risingtideresearch/CANbus-Logging-Bridge/README.md

# CANbus-Logging-Bridge
Platform for collecting, logging, interpreting, and relaying CAN messages on multiple busses
