risingtideresearch/CANbus-Logging-Bridge/(threads)

Thread 1 (2025-07-22):

Changes from V01 testing

NPoole, 2025-07-22:
I'm going to use this issue to track my TODO as I test the prototype.

First on the list, I'll probably rename this repo and the project "CANbus Gateway" because that's what the name has become in meetings and it's less of a mouthful.

NPoole, 2025-07-22:
- Not proven to cause problems yet, but a mistake none-the-less: the VUSB LDO's enable pin is connected directly to VUSB while the input pin gets VUSB through a diode drop. The enable pin should get the same level as the input.
