risingtideresearch/CANbus-Logging-Bridge/CANbus_Logging_Bridge/CANbus_Logging_Bridge.kicad_pcb

## KiCad design CANbus_Logging_Bridge/CANbus_Logging_Bridge.kicad_pcb (2025-05-25)

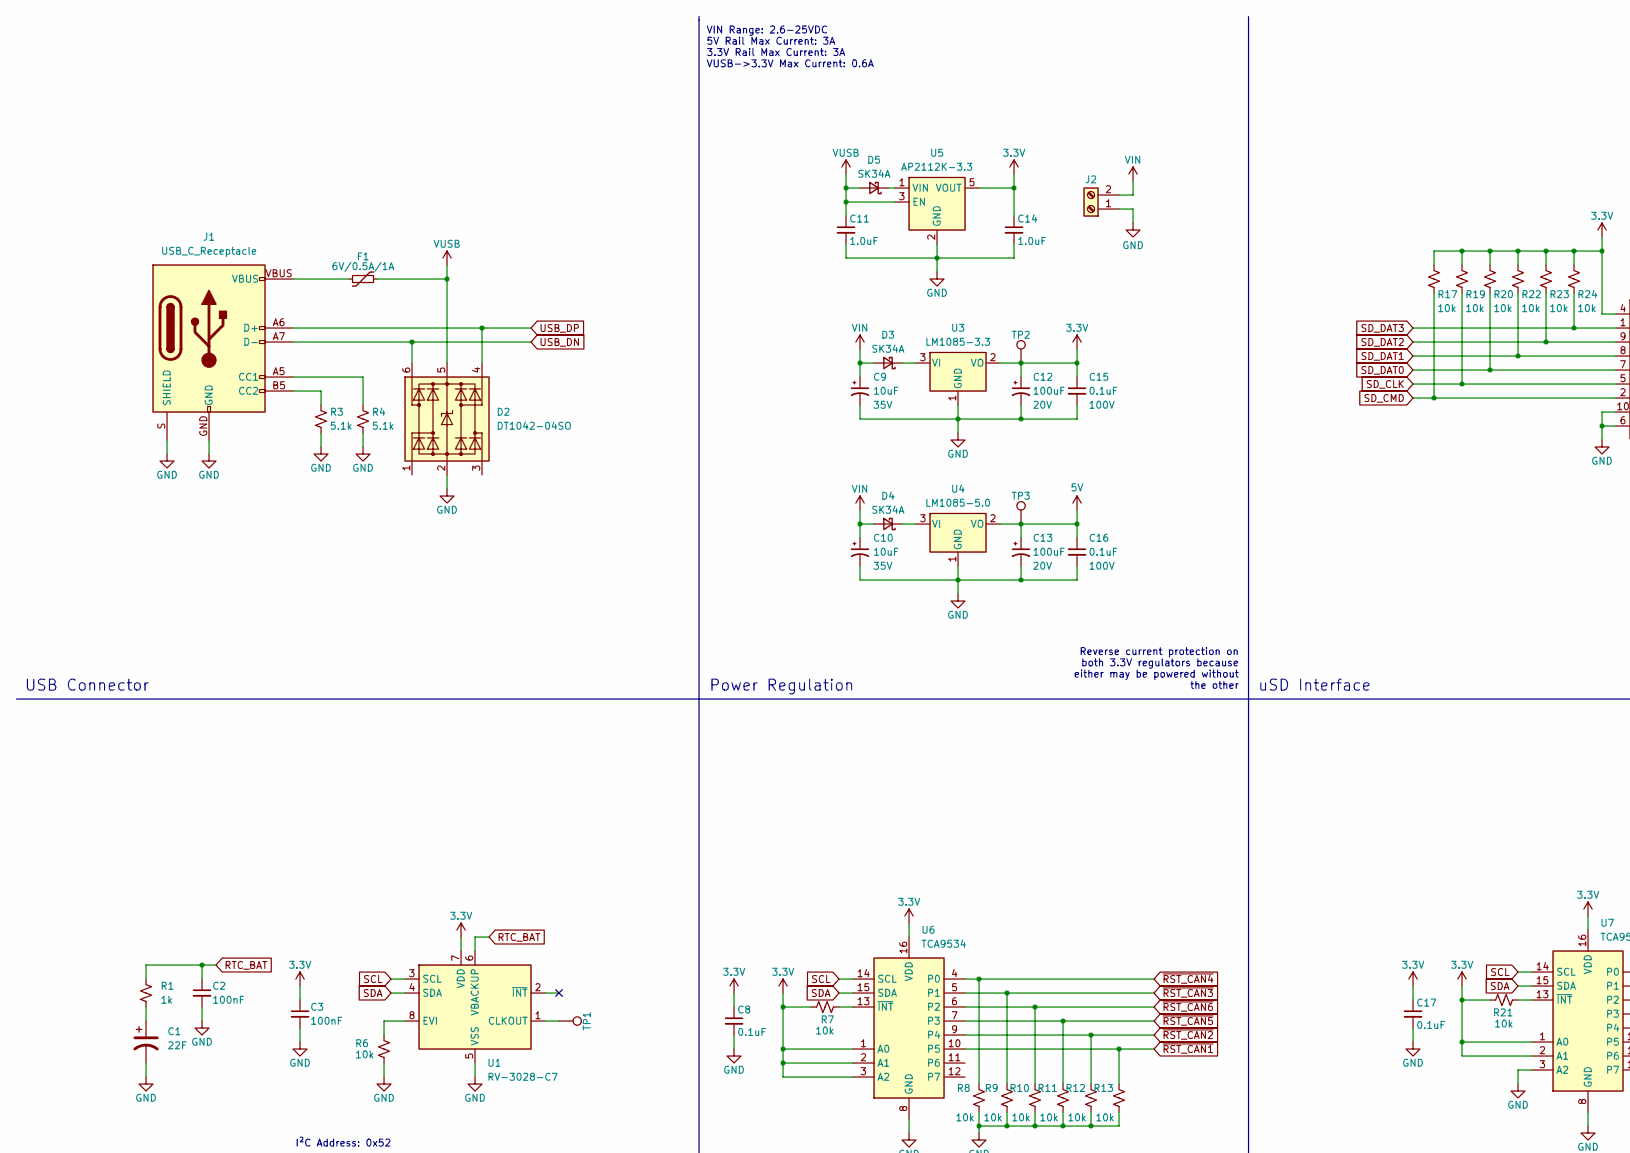
[picture p1: schematic CANbus_Logging_Bridge.kicad_sch, CAN Bus Logging and Bridge, part in row 1, column 1]

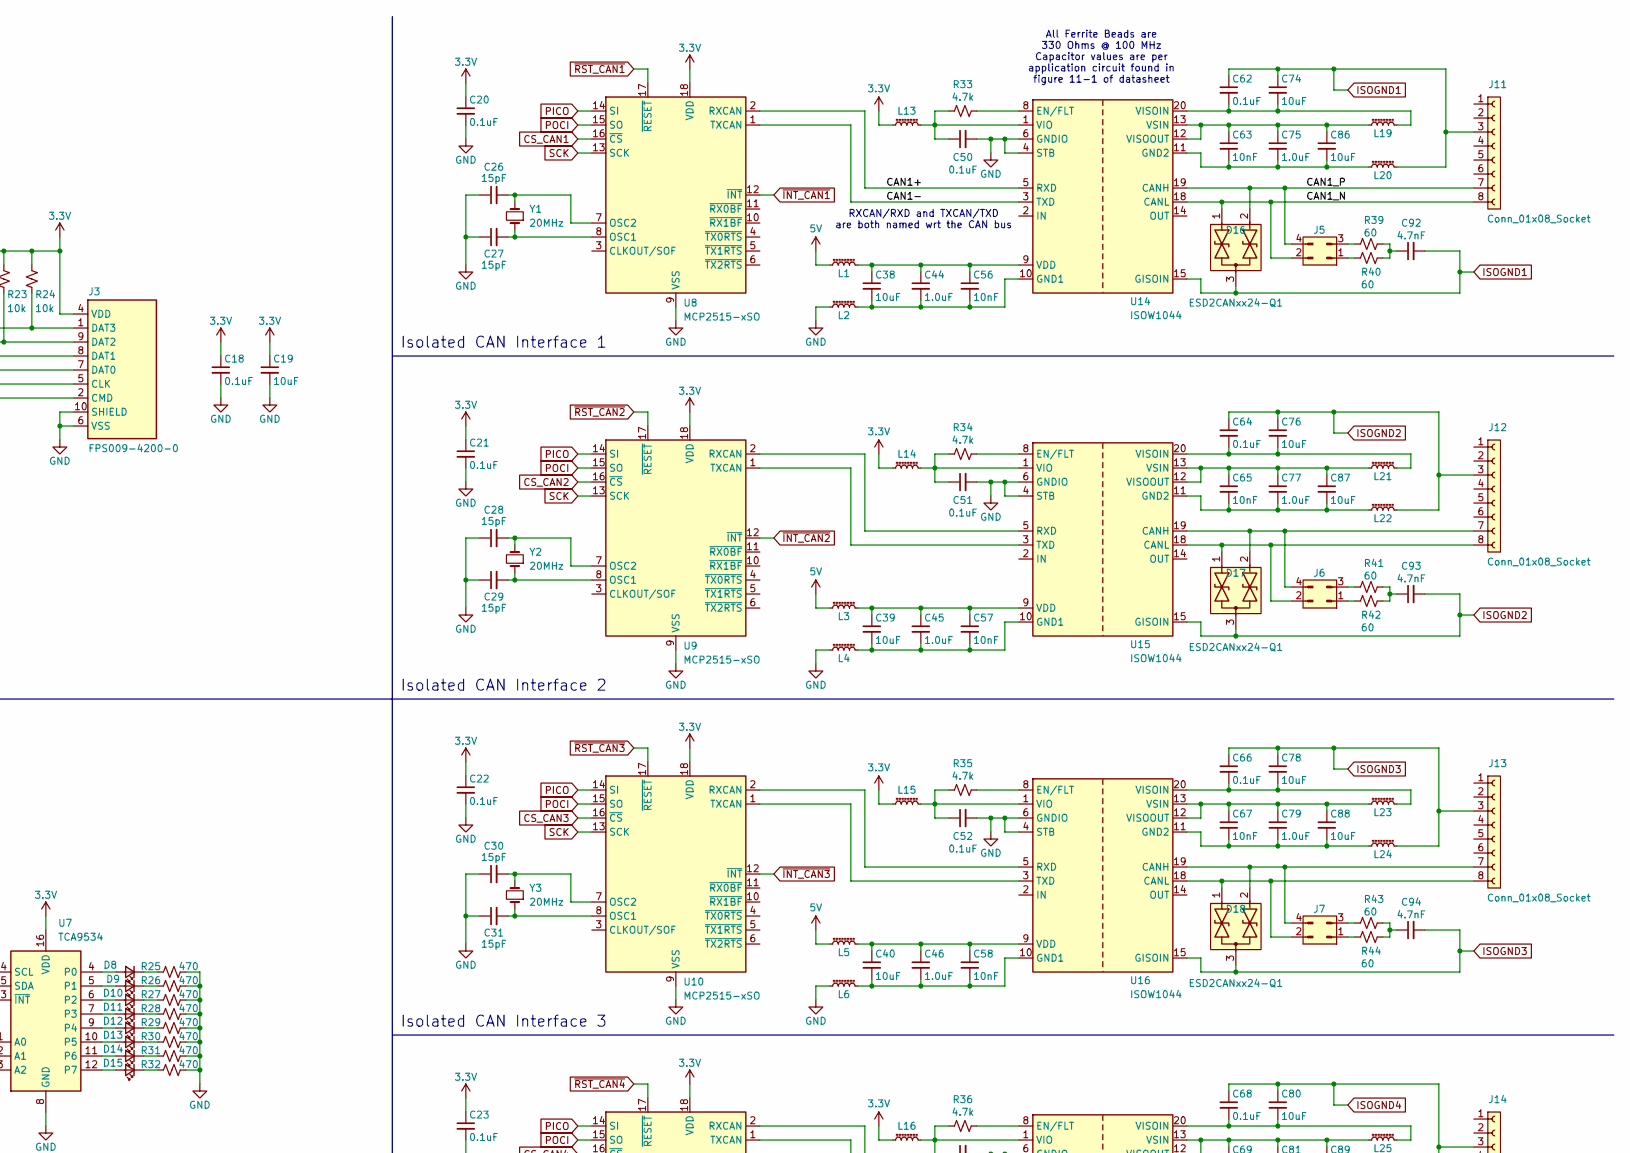
[picture p2: schematic CANbus_Logging_Bridge.kicad_sch, CAN Bus Logging and Bridge, part in row 1, column 2]

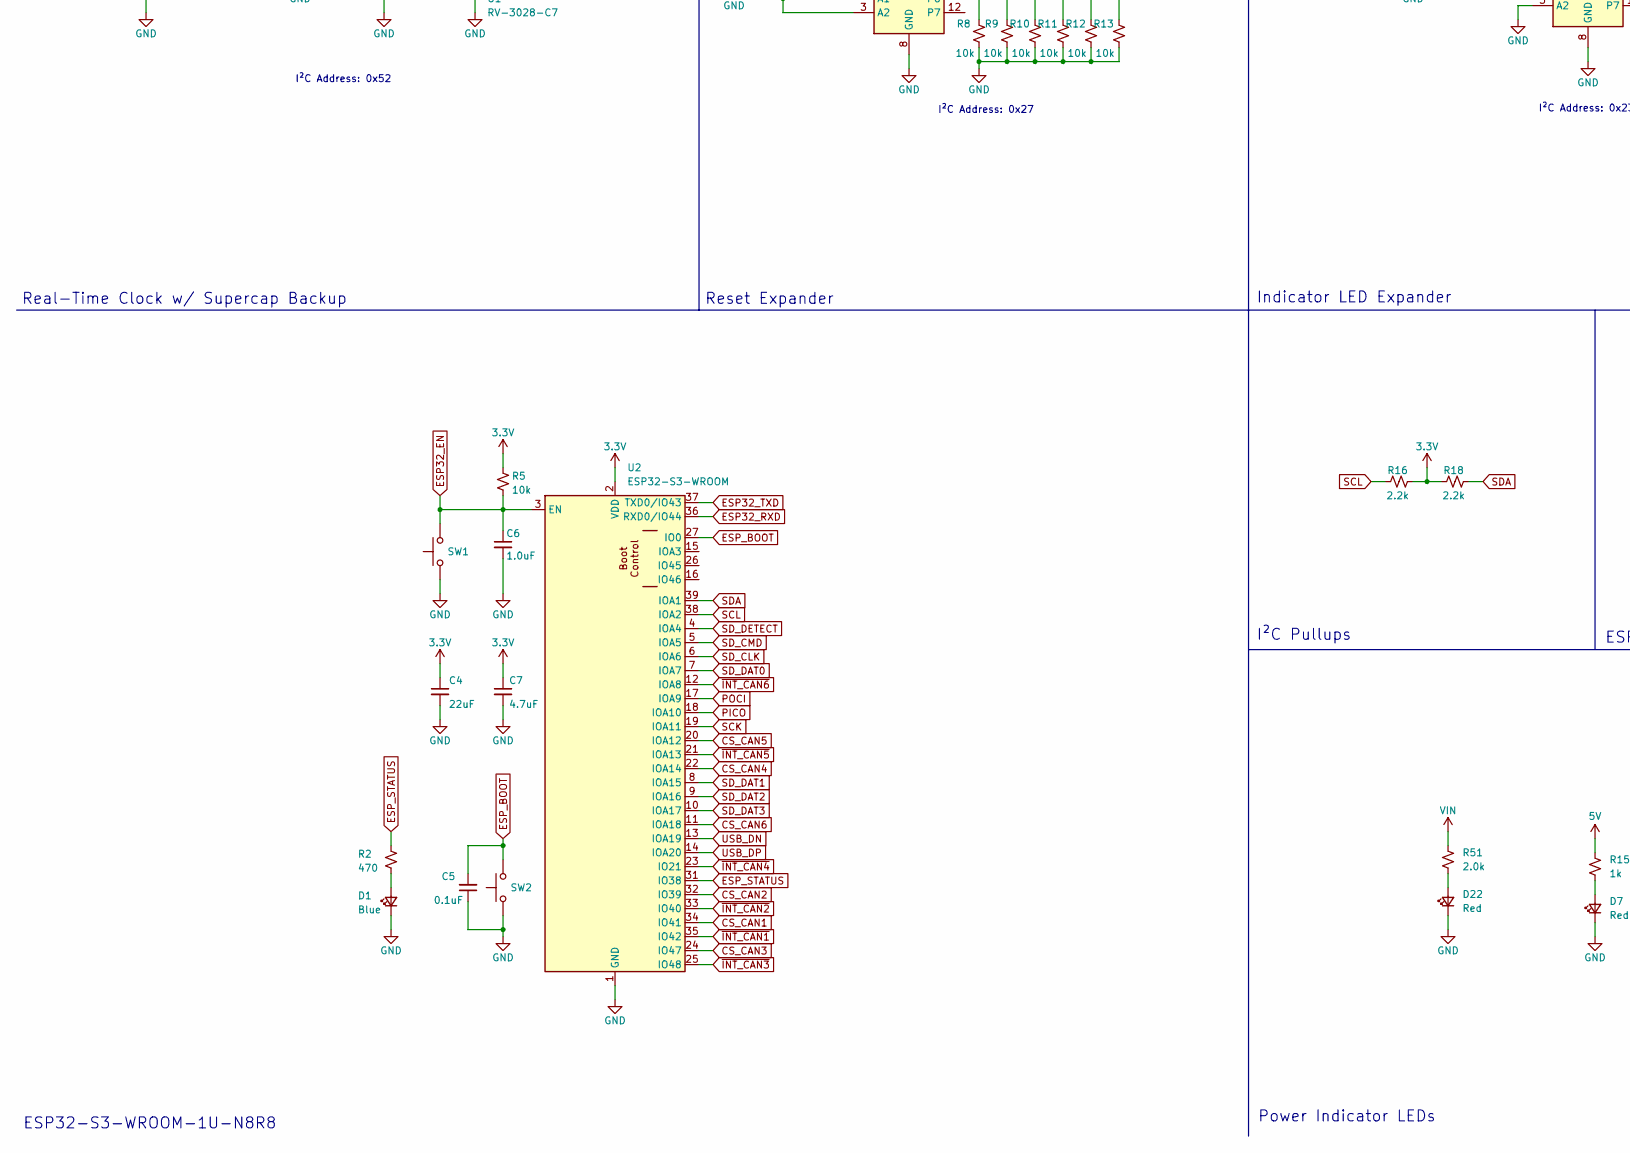
[picture p3: schematic CANbus_Logging_Bridge.kicad_sch, CAN Bus Logging and Bridge, part in row 2, column 1]

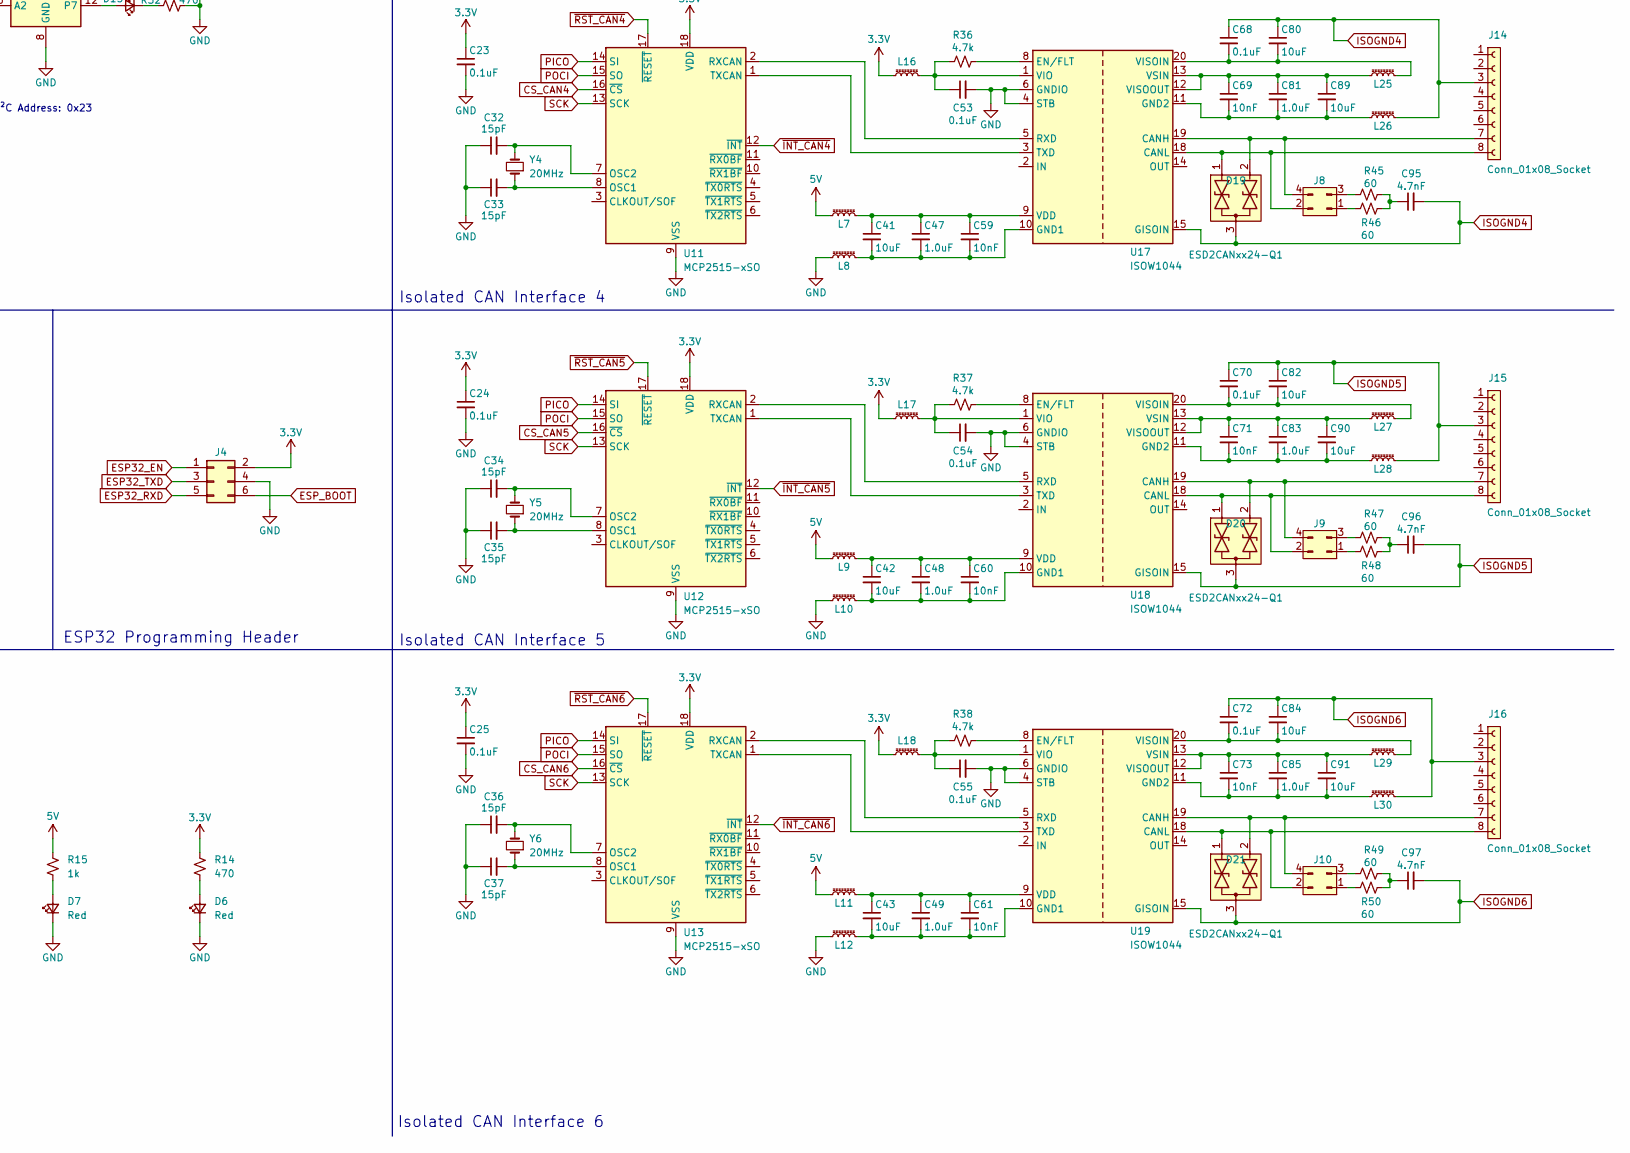
[picture p4: schematic CANbus_Logging_Bridge.kicad_sch, CAN Bus Logging and Bridge, part in row 2, column 2]

Parts:
C1: 22F; 4.8_CoinCell_Dynacap
C2, C3: 100nF; C_0402_1005Metric; Voltage 25V; Tolerance 10%
C4: 22uF; C_0402_1005Metric; Voltage 6.3V; Tolerance 20%
C5, C8, C17, C18, C20, C21, C22, C23, C24, C25, C50, C51, C52, C53, C54, C55, C62, C64, C66, C68, C70, C72: 0.1uF; C_0402_1005Metric; Voltage 16V; Tolerance 10%
C6, C11, C14, C44, C45, C46, C47, C48, C49, C75, C77, C79, C81, C83, C85: 1.0uF; C_0402_1005Metric; Voltage 16V; Tolerance 10%
C7: 4.7uF; C_0402_1005Metric; Voltage 6.3V; Tolerance 20%
C9, C10: 10uF; CP_EIA-7343-30_AVX-N; Voltage 35V; Tolerance 20%
C12, C13: 100uF; CP_EIA-7343-30_AVX-N; Voltage 20V; Tolerance 10%
C15, C16: 0.1uF; C_0603_1608Metric; Voltage 100V; Tolerance 10%
C19, C38, C39, C40, C41, C42, C43, C74, C76, C78, C80, C82, C84, C86, C87, C88, C89, C90, C91: 10uF; C_0402_1005Metric; Voltage 6.3V; Tolerance 20%
C26, C27, C28, C29, C30, C31, C32, C33, C34, C35, C36, C37: 15pF; C_0402_1005Metric; Voltage 50V; Tolerance 5%
C56, C57, C58, C59, C60, C61, C63, C65, C67, C69, C71, C73: 10nF; C_0402_1005Metric; Voltage 25V; Tolerance 10%
C92, C93, C94, C95, C96, C97: 4.7nF; C_0402_1005Metric
D1, D8, D9, D10, D11, D12, D13, D14, D15: Blue; LED_0603_1608Metric
D2: DT1042-04SO; SOT23-6
D3, D4, D5: SK34A; SMA
D6, D7, D22: Red; LED_0603_1608Metric
D16, D17, D18, D19, D20, D21: ESD2CANxx24-Q1; SOT-323_SC-70
F1: 6V/0.5A/1A; 0805
J1: USB_C_Receptacle; USB-C_16
J2: Screw_Terminal_01x02; TerminalBlock_DoraboDBT10_8.5mm
J3: FPS009-4200-0; FPS00942000; Mouser Part Number 945-FPS009-4200-0
J4: Conn_02x03_Odd_Even; PinHeader_2x03_P2.54mm_Vertical
J5, J6, J7, J8, J9, J10: Conn_02x02_Pin; PinHeader_2x02_P2.54mm_Vertical_SMD
J11, J12, J13, J14, J15, J16: Conn_01x08_Socket; 1x08
L1, L2, L3, L4, L5, L6, L7, L8, L9, L10, L11, L12, L13, L14, L15, L16, L17, L18, L19, L20, L21, L22, L23, L24, L25, L26, L27, L28, L29, L30: 330 OHM; C_0402_1005Metric
R1, R15: 1k; R_0402_1005Metric
R2, R14, R25, R26, R27, R28, R29, R30, R31, R32: 470; R_0402_1005Metric
R3, R4: 5.1k; R_0402_1005Metric
R5, R6, R7, R8, R9, R10, R11, R12, R13, R17, R19, R20, R21, R22, R23, R24: 10k; R_0402_1005Metric
R16, R18: 2.2k; R_0402_1005Metric
R33, R34, R35, R36, R37, R38: 4.7k; R_0402_1005Metric
R39, R40, R41, R42, R43, R44, R45, R46, R47, R48, R49, R50: 60; R_0402_1005Metric
R51: 2.0k; R_1206_3216Metric
SW1, SW2: SMD_5.2x5.2mm_h1.9mm; Push_SMD_5.2x5.2mm_h1.9mm
TP1, TP2, TP3: 1.0mm; TestPoint-1.0mm
U1: RV-3028-C7; MicroCrystal_C7_SON-8_1.5x3.2mm_P0.9mm
U2: ESP32-S3-WROOM; ESP32-S3-WROOM-1U
U3: LM1085-3.3; TO-263-3_TabPin2
U4: LM1085-5.0; TO-263-3_TabPin2
U5: AP2112K-3.3; SOT23-5
U6, U7: TCA9534; SOIC-16W_7.5x10.3mm_P1.27mm
U8, U9, U10, U11, U12, U13: MCP2515-xSO; SOIC-18W_7.5x11.6mm_P1.27mm
U14, U15, U16, U17, U18, U19: ISOW1044; SOIC-20W_7.5x12.8mm_P1.27mm
Y1, Y2, Y3, Y4, Y5, Y6: 20MHz; Crystal_SMD_2.0x1.6mm

Connections:
3.3V: C3.1, C4.1, C7.1, C8.1, C12.1, C14.1, C15.1, C17.1, C18.1, C19.1, C20.1, C21.1, C22.1, C23.1, C24.1, C25.1, J3.4 (VDD), J4.2, L13.1, L14.1, L15.1, L16.1, L17.1, L18.1, R5.2, R7.1, R14.2, R16.1, R17.2, R18.2, R19.2, R20.2, R21.1, R22.2, R23.2, R24.2, TP2.1, U1.7 (VDD), U2.2 (VDD), U3.2 (VO), U5.5 (VOUT), U6.1 (A0), U6.2 (A1), U6.3 (A2), U6.16 (VDD), U7.1 (A0), U7.2 (A1), U7.16 (VDD), U8.18 (VDD), U9.18 (VDD), U10.18 (VDD), U11.18 (VDD), U12.18 (VDD), U13.18 (VDD)
5V: C13.1, C16.1, L1.1, L3.1, L5.1, L7.1, L9.1, L11.1, R15.2, TP3.1, U4.2 (VO)
/CAN1+: U8.2 (RXCAN), U14.5 (RXD)
/CAN1-: U8.1 (TXCAN), U14.3 (TXD)
/CAN1_N: D16.1 (A1), J5.2, J11.8, U14.18 (CANL)
/CAN1_P: D16.2 (A2), J5.4, J11.7, U14.19 (CANH)
CS_CAN1: U2.34 (IO41), U8.16 (~CS)
CS_CAN2: U2.32 (IO39), U9.16 (~CS)
CS_CAN3: U2.24 (IO47), U10.16 (~CS)
CS_CAN4: U2.22 (IOA14), U11.16 (~CS)
CS_CAN5: U2.20 (IOA12), U12.16 (~CS)
CS_CAN6: U2.11 (IOA18), U13.16 (~CS)
ESP32_EN: C6.1, J4.1, R5.1, SW1.2, U2.3 (EN)
ESP32_RXD: J4.5, U2.36 (RXD0/IO44)
ESP32_TXD: J4.3, U2.37 (TXD0/IO43)
ESP_BOOT: C5.2, J4.6, SW2.2, U2.27 (IO0)
ESP_STATUS: R2.2, U2.31 (IO38)
GND: C1.-, C2.2, C3.2, C4.2, C5.1, C6.2, C7.2, C8.2, C9.2, C10.2, C11.2, C12.2, C13.2, C14.2, C15.2, C16.2, C17.2, C18.2, C19.2, C20.2, C21.2, C22.2, C23.2, C24.2, C25.2, C26.1, C27.1, C28.1, C29.1, C30.1, C31.1, C32.1, C33.1, C34.1, C35.1, C36.1, C37.1, C50.2, C51.2, C52.2, C53.2, C54.2, C55.2, D1.1 (K), D2.2 (GND), D6.1 (K), D7.1 (K), D22.1 (K), J1.GND, J1.S (SHIELD), J2.1, J3.3 (VSS), J3.6 (VSS), J3.10 (SHIELD), J3.11 (SHIELD), J3.12 (SHIELD), J3.13 (SHIELD), J4.4, L2.1, L4.1, L6.1, L8.1, L10.1, L12.1, R3.1, R4.1, R6.1, R8.2, R9.2, R10.2, R11.2, R12.2, R13.2, R25.1, R26.1, R27.1, R28.1, R29.1, R30.1, R31.1, R32.1, SW1.1, SW2.1, U1.5 (VSS), U2.1 (GND), U2.40 (GND), U2.41.1 (GND), U2.41.2 (GND), U2.41.3 (GND), U2.41.4 (GND), U2.41.5 (GND), U2.41.6 (GND), U2.41.7 (GND), U2.41.8 (GND), U2.41.9 (GND), U3.1 (GND), U4.1 (GND), U5.2 (GND), U6.8 (GND), U7.3 (A2), U7.8 (GND), U8.9 (VSS), U9.9 (VSS), U10.9 (VSS), U11.9 (VSS), U12.9 (VSS), U13.9 (VSS), U14.4 (STB), U14.6 (GNDIO), U15.4 (STB), U15.6 (GNDIO), U16.4 (STB), U16.6 (GNDIO), U17.4 (STB), U17.6 (GNDIO), U18.4 (STB), U18.6 (GNDIO), U19.4 (STB), U19.6 (GNDIO)
unnamed: C1.+, R1.1
unnamed: C92.1, R39.1, R40.1
unnamed: C93.1, R41.1, R42.1
unnamed: C94.1, R43.1, R44.1
unnamed: C95.1, R45.1, R46.1
unnamed: C96.1, R47.1, R48.1
unnamed: C97.1, R49.1, R50.1
unnamed: D1.2 (A), R2.1
unnamed: D3.C (K), U3.3 (VI)
unnamed: D4.C (K), U4.3 (VI)
unnamed: D5.C (K), U5.1 (VIN)
unnamed: D6.2 (A), R14.1
unnamed: D7.2 (A), R15.1
unnamed: D8.2 (A), U7.4 (P0)
unnamed: D8.1 (K), R25.2
unnamed: D9.2 (A), U7.5 (P1)
unnamed: D9.1 (K), R26.2
unnamed: D10.2 (A), U7.6 (P2)
unnamed: D10.1 (K), R27.2
unnamed: D11.2 (A), U7.7 (P3)
unnamed: D11.1 (K), R28.2
unnamed: D12.2 (A), U7.9 (P4)
unnamed: D12.1 (K), R29.2
unnamed: D13.2 (A), U7.10 (P5)
unnamed: D13.1 (K), R30.2
unnamed: D14.2 (A), U7.11 (P6)
unnamed: D14.1 (K), R31.2
unnamed: D15.2 (A), U7.12 (P7)
unnamed: D15.1 (K), R32.2
unnamed: D17.1 (A1), J6.2, J12.8, U15.18 (CANL)
unnamed: D17.2 (A2), J6.4, J12.7, U15.19 (CANH)
unnamed: D18.1 (A1), J7.2, J13.8, U16.18 (CANL)
unnamed: D18.2 (A2), J7.4, J13.7, U16.19 (CANH)
unnamed: D19.1 (A1), J8.2, J14.8, U17.18 (CANL)
unnamed: D19.2 (A2), J8.4, J14.7, U17.19 (CANH)
unnamed: D20.1 (A1), J9.2, J15.8, U18.18 (CANL)
unnamed: D20.2 (A2), J9.4, J15.7, U18.19 (CANH)
unnamed: D21.1 (A1), J10.2, J16.8, U19.18 (CANL)
unnamed: D21.2 (A2), J10.4, J16.7, U19.19 (CANH)
unnamed: D22.2 (A), R51.1
unnamed: F1.1, J1.VBUS
unnamed: J1.A5 (CC1), R4.2
unnamed: J1.B5 (CC2), R3.2
unnamed: J5.1, R40.2
unnamed: J5.3, R39.2
unnamed: J6.1, R42.2
unnamed: J6.3, R41.2
unnamed: J7.1, R44.2
unnamed: J7.3, R43.2
unnamed: J8.1, R46.2
unnamed: J8.3, R45.2
unnamed: J9.1, R48.2
unnamed: J9.3, R47.2
unnamed: J10.1, R50.2
unnamed: J10.3, R49.2
unnamed: TP1.1, U1.1 (CLKOUT)
unnamed: R6.2, U1.8 (EVI)
unnamed: R7.2, U6.13 (~INT)
unnamed: R21.2, U7.13 (~INT)
unnamed: C27.2, U8.8 (OSC1), Y1.1
unnamed: C26.2, U8.7 (OSC2), Y1.2
unnamed: C29.2, U9.8 (OSC1), Y2.1
unnamed: C28.2, U9.7 (OSC2), Y2.2
unnamed: C31.2, U10.8 (OSC1), Y3.1
unnamed: C30.2, U10.7 (OSC2), Y3.2
unnamed: U10.2 (RXCAN), U16.5 (RXD)
unnamed: U10.1 (TXCAN), U16.3 (TXD)
unnamed: C33.2, U11.8 (OSC1), Y4.1
unnamed: C32.2, U11.7 (OSC2), Y4.2
unnamed: U11.2 (RXCAN), U17.5 (RXD)
unnamed: U11.1 (TXCAN), U17.3 (TXD)
unnamed: C35.2, U12.8 (OSC1), Y5.1
unnamed: C34.2, U12.7 (OSC2), Y5.2
unnamed: U12.2 (RXCAN), U18.5 (RXD)
unnamed: U12.1 (TXCAN), U18.3 (TXD)
unnamed: C37.2, U13.8 (OSC1), Y6.1
unnamed: C36.2, U13.7 (OSC2), Y6.2
unnamed: U13.2 (RXCAN), U19.5 (RXD)
unnamed: U13.1 (TXCAN), U19.3 (TXD)
unnamed: R33.2, U14.8 (EN/FLT)
unnamed: C38.2, C44.2, C56.2, L2.2, U14.10 (GND1)
unnamed: C63.2, C75.2, C86.2, L20.1, U14.11 (GND2)
unnamed: C38.1, C44.1, C56.1, L1.2, U14.9 (VDD)
unnamed: C50.1, L13.2, R33.1, U14.1 (VIO)
unnamed: C62.2, C74.2, L19.2, U14.20 (VISOIN)
unnamed: C63.1, C75.1, C86.1, L19.1, U14.12 (VISOOUT), U14.13 (VSIN)
unnamed: R34.2, U15.8 (EN/FLT)
unnamed: C39.2, C45.2, C57.2, L4.2, U15.10 (GND1)
unnamed: C65.2, C77.2, C87.2, L22.1, U15.11 (GND2)
unnamed: U9.2 (RXCAN), U15.5 (RXD)
unnamed: U9.1 (TXCAN), U15.3 (TXD)
unnamed: C39.1, C45.1, C57.1, L3.2, U15.9 (VDD)
unnamed: C51.1, L14.2, R34.1, U15.1 (VIO)
unnamed: C64.2, C76.2, L21.2, U15.20 (VISOIN)
unnamed: C65.1, C77.1, C87.1, L21.1, U15.12 (VISOOUT), U15.13 (VSIN)
unnamed: R35.2, U16.8 (EN/FLT)
unnamed: C40.2, C46.2, C58.2, L6.2, U16.10 (GND1)
unnamed: C67.2, C79.2, C88.2, L24.1, U16.11 (GND2)
unnamed: C40.1, C46.1, C58.1, L5.2, U16.9 (VDD)
unnamed: C52.1, L15.2, R35.1, U16.1 (VIO)
unnamed: C66.2, C78.2, L23.2, U16.20 (VISOIN)
unnamed: C67.1, C79.1, C88.1, L23.1, U16.12 (VISOOUT), U16.13 (VSIN)
unnamed: R36.2, U17.8 (EN/FLT)
unnamed: C41.2, C47.2, C59.2, L8.2, U17.10 (GND1)
unnamed: C69.2, C81.2, C89.2, L26.1, U17.11 (GND2)
unnamed: C41.1, C47.1, C59.1, L7.2, U17.9 (VDD)
unnamed: C53.1, L16.2, R36.1, U17.1 (VIO)
unnamed: C68.2, C80.2, L25.2, U17.20 (VISOIN)
unnamed: C69.1, C81.1, C89.1, L25.1, U17.12 (VISOOUT), U17.13 (VSIN)
unnamed: R37.2, U18.8 (EN/FLT)
unnamed: C42.2, C48.2, C60.2, L10.2, U18.10 (GND1)
unnamed: C71.2, C83.2, C90.2, L28.1, U18.11 (GND2)
unnamed: C42.1, C48.1, C60.1, L9.2, U18.9 (VDD)
unnamed: C54.1, L17.2, R37.1, U18.1 (VIO)
unnamed: C70.2, C82.2, L27.2, U18.20 (VISOIN)
unnamed: C71.1, C83.1, C90.1, L27.1, U18.12 (VISOOUT), U18.13 (VSIN)
unnamed: R38.2, U19.8 (EN/FLT)
unnamed: C43.2, C49.2, C61.2, L12.2, U19.10 (GND1)
unnamed: C73.2, C85.2, C91.2, L30.1, U19.11 (GND2)
unnamed: C43.1, C49.1, C61.1, L11.2, U19.9 (VDD)
unnamed: C55.1, L18.2, R38.1, U19.1 (VIO)
unnamed: C72.2, C84.2, L29.2, U19.20 (VISOIN)
unnamed: C73.1, C85.1, C91.1, L29.1, U19.12 (VISOOUT), U19.13 (VSIN)
PICO: U2.18 (IOA10), U8.14 (SI), U9.14 (SI), U10.14 (SI), U11.14 (SI), U12.14 (SI), U13.14 (SI)
POCI: U2.17 (IOA9), U8.15 (SO), U9.15 (SO), U10.15 (SO), U11.15 (SO), U12.15 (SO), U13.15 (SO)
RTC_BAT: C2.1, R1.2, U1.6 (VBACKUP)
SCK: U2.19 (IOA11), U8.13 (SCK), U9.13 (SCK), U10.13 (SCK), U11.13 (SCK), U12.13 (SCK), U13.13 (SCK)
SCL: R16.2, U1.3 (SCL), U2.38 (IOA2), U6.14 (SCL), U7.14 (SCL)
SDA: R18.1, U1.4 (SDA), U2.39 (IOA1), U6.15 (SDA), U7.15 (SDA)
SD_CLK: J3.5 (CLK), R19.1, U2.6 (IOA6)
SD_CMD: J3.2 (CMD), R17.1, U2.5 (IOA5)
SD_DAT0: J3.7 (DAT0), R20.1, U2.7 (IOA7)
SD_DAT1: J3.8 (DAT1), R22.1, U2.8 (IOA15)
SD_DAT2: J3.9 (DAT2), R23.1, U2.9 (IOA16)
SD_DAT3: J3.1 (DAT3), R24.1, U2.10 (IOA17)
SD_DETECT: U2.4 (IOA4)
USB_DN: D2.6 (I/O4), J1.A7 (D-), J1.B7 (D-), U2.13 (IOA19)
USB_DP: D2.4 (I/O3), J1.A6 (D+), J1.B6 (D+), U2.14 (IOA20)
VIN: C9.1, C10.1, D3.A, D4.A, J2.2, R51.2
VUSB: C11.1, D2.5 (VCC), D5.A, F1.2, U5.3 (EN)
~INT_CAN1: U2.35 (IO42), U8.12 (~INT)
~INT_CAN2: U2.33 (IO40), U9.12 (~INT)
~INT_CAN3: U2.25 (IO48), U10.12 (~INT)
~INT_CAN4: U2.23 (IO21), U11.12 (~INT)
~INT_CAN5: U2.21 (IOA13), U12.12 (~INT)
~INT_CAN6: U2.12 (IOA8), U13.12 (~INT)
~RST_CAN1: R13.1, U6.10 (P5), U8.17 (~RESET)
~RST_CAN2: R12.1, U6.9 (P4), U9.17 (~RESET)
~RST_CAN3: R9.1, U6.5 (P1), U10.17 (~RESET)
~RST_CAN4: R8.1, U6.4 (P0), U11.17 (~RESET)
~RST_CAN5: R11.1, U6.7 (P3), U12.17 (~RESET)
~RST_CAN6: R10.1, U6.6 (P2), U13.17 (~RESET)

Notes on the sheet:
Indicator LED Expander
Reverse current protection on both 3.3V regulators because either may be powered without the other
Power Regulation
Isolated CAN Interface 4
I²C Address: 0x27
VIN Range: 2.6-25VDC 5V Rail Max Current: 3A 3.3V Rail Max Current: 3A VUSB->3.3V Max Current: 0.6A
ESP32-S3-WROOM-1U-N8R8
I²C Address: 0x52
RXCAN/RXD and TXCAN/TXD are both named wrt the CAN bus
I²C Pullups
Isolated CAN Interface 5
Isolated CAN Interface 3
Reset Expander
USB Connector
Isolated CAN Interface 6
ESP32 Programming Header
Real-Time Clock w/ Supercap Backup
Isolated CAN Interface 1
I²C Address: 0x23
uSD Interface
Isolated CAN Interface 2
Power Indicator LEDs
All Ferrite Beads are 330 Ohms @ 100 MHz Capacitor values are per application circuit found in figure 11-1 of datasheet

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
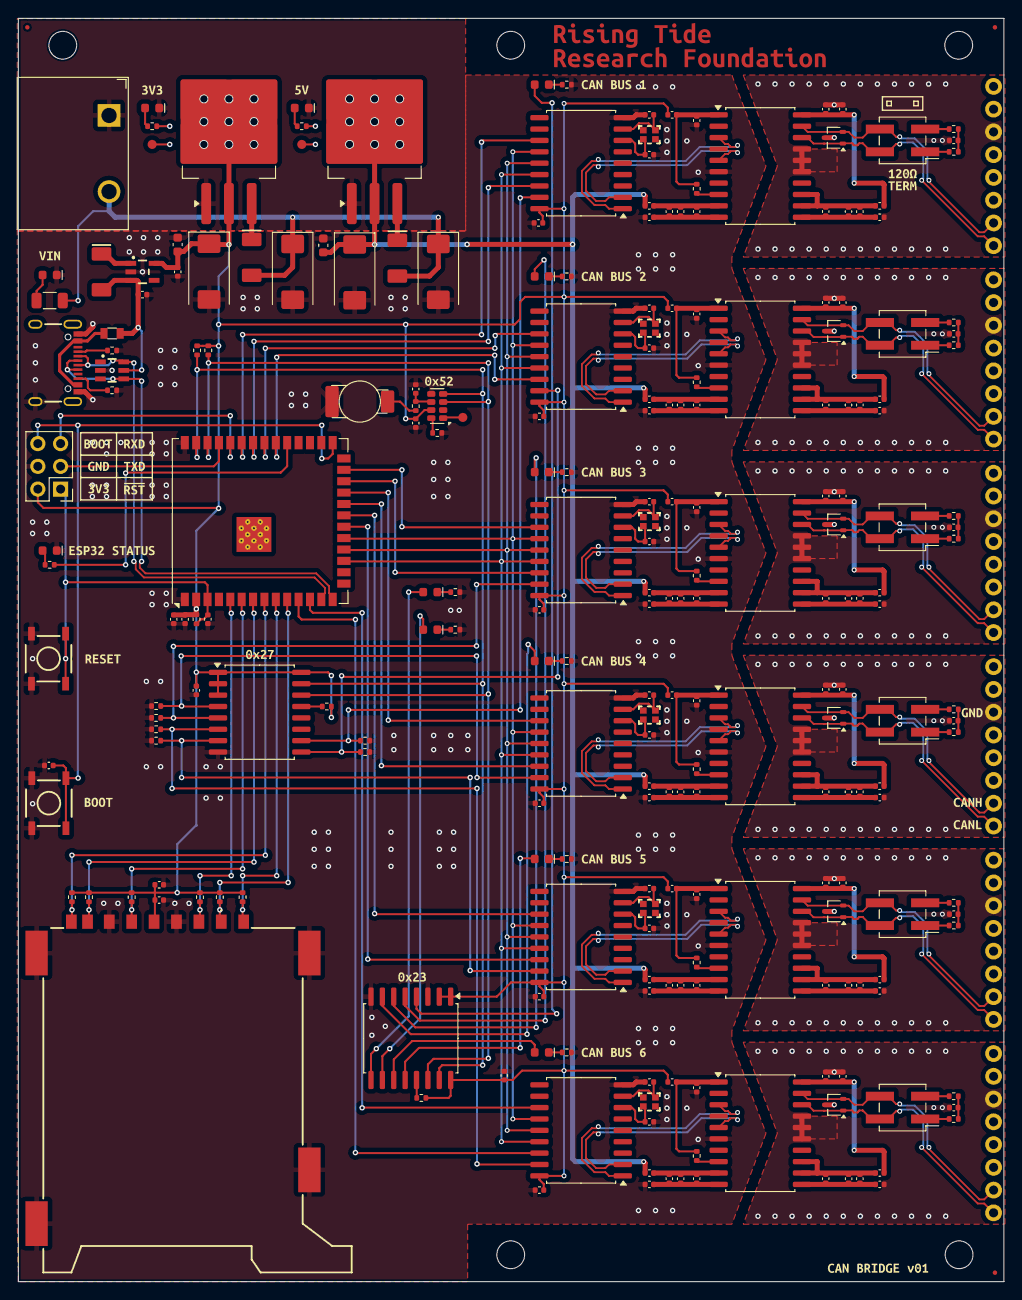
[picture p5: board CANbus_Logging_Bridge.kicad_pcb from above]

Board: 4 copper layers, 110.0 x 141.0 mm, 278 parts (1 on the bottom side), 175 nets.

Other parts of the board:
Ref**: Fiducial_0.5mm_Mask1mm
Ref**#2, Ref**#3: Fiducial_0.5mm_Mask1mm
kibuzzard-683381FB: G***; kibuzzard-683381FB
kibuzzard-683384E4: G***; kibuzzard-683384E4
kibuzzard-683384F2: G***; kibuzzard-683384F2
kibuzzard-683385A1: G***; kibuzzard-683385A1
kibuzzard-683385A6: G***; kibuzzard-683385A6
kibuzzard-683390BD: G***; kibuzzard-683390BD
kibuzzard-683390C2: G***; kibuzzard-683390C2
kibuzzard-683390DA: G***; kibuzzard-683390DA
kibuzzard-683390E1: G***; kibuzzard-683390E1
kibuzzard-683390E7: G***; kibuzzard-683390E7
kibuzzard-683393CD: G***; kibuzzard-683393CD
kibuzzard-6833820A: G***; kibuzzard-6833820A
kibuzzard-6833851A: G***; kibuzzard-6833851A
kibuzzard-6833856B: G***; kibuzzard-6833856B
kibuzzard-6833858D: G***; kibuzzard-6833858D
kibuzzard-6833859C: G***; kibuzzard-6833859C
kibuzzard-6833916E: G***; kibuzzard-6833916E
kibuzzard-6833918D: G***; kibuzzard-6833918D
kibuzzard-6833959C: G***; kibuzzard-6833959C
kibuzzard-68338202: G***; kibuzzard-68338202
kibuzzard-68338593: G***; kibuzzard-68338593
kibuzzard-68338682: G***; kibuzzard-68338682
kibuzzard-68339090: G***; kibuzzard-68339090
kibuzzard-68339145: G***; kibuzzard-68339145
kibuzzard-68339228: G***; kibuzzard-68339228
kibuzzard-68339419: G***; kibuzzard-68339419
kibuzzard-68339449: G***; kibuzzard-68339449
kibuzzard-68339454: G***; kibuzzard-68339454
