risingtideresearch/CANbus-Logging-Bridge/(commit log)

2025-05-06 Initial Commit
    Initial circuit design
    No changes made since 5/5 meeting
    Pushing for review
    [CANbus_Logging_Bridge.kicad_pcb, CANbus_Logging_Bridge.kicad_sch]
2025-05-25 v01 layout pre-silk
    Project:
    -Add datasheets
    SCH:
    -Add termination resistors/jumpers to CAN lines
    -Swap microSD socket to full SD socket
    -Change RJ45 pinout to VE.Can pinout
    -Double check SPI pinout on ESP32
    -Reverse CAN ~{RST} bias so that devices are held in reset by default
    -Move LED off IO0 and add 0.1 capacitor
    -Address USB power situation
    -Connect CAN ~{INT} lines to ESP32
    -Breakout EN, IO0, U0TXD, U0RXD, 3.3V and GND
    -Update RTC (Part is NRFND)
    -Add Power Status LEDs
    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
    [CANbus_Logging_Bridge.kicad_pcb, CANbus_Logging_Bridge.kicad_sch]
2025-05-25 Layout v01
    -Add Silk
    -Ground Stitching
    [CANbus_Logging_Bridge.kicad_pcb, CANbus_Logging_Bridge.kicad_sch]
2025-06-24 Migrate to RisingTideResearch-Libs
    - Change all component references to the new KiCad libraries
    - Remove datasheets directory as datasheets are now embedded
2025-07-24 Update all symbols and footprints from lib
    - Update symbols and footprints (lib updated with LCSC part numbers)
    - Replace 60R resistors with closest E96 value (60.4R)
2025-12-16 Upload prototype firmware in progress
    It doesn't compile at the moment, I was caught in the middle of some changes
    [Gateway_Test_Integrated_multiwrite_lint.ino]
2025-12-28 Update Gateway_Test_Integrated_multiwrite_lint.ino
    Doing too much in the ISR, committing for posterity.
    Menu is most pleasant to navigate in Realterm with Ansi display in NewLine mode (or equivalent terminal emulator)
    [Gateway_Test_Integrated_multiwrite_lint.ino]
2026-01-06 Update Gateway_Test_Integrated_multiwrite_lint.ino
    Firmware now logs all six channels at near saturation.
    - Create struct for CAN frames
    - Expand SD write buffer
    - Declare `volatile` for globals that are touched by ISR
    - Declare `const` for pin-assignment arrays
    - Add serial debug stuff to monitor ring buffers
    - Avoid writing junk bytes to SD by respecting data length byte when transcribing from CANFrame struct to SD write buffer
    - Add mutex to prevent ISR collision (shouldn't be a thing, this may be unnecessary)
    -Remove unused convenience functions
    [Gateway_Test_Integrated_multiwrite_lint.ino]
2026-01-13 Update Gateway_Test_Integrated_multiwrite_lint.ino
    - Add struct members to CANFrame for frame metadata
    - Add expandFrame() to translate raw MCP register bytes to frame metadata
    - Fix log formatting
    - Add timestamps using POSIX style gettimeofday() calls
    - Move tasks and core assignments around in an attempt to solve assumed SPI driver (possibly GPIO matrix?) delays.
    - Change delays in main loops to non-blocking delays to ensure watchdogs get fed
    [Gateway_Test_Integrated_multiwrite_lint.ino]
2026-02-22 Layout and routing for v02
    - New 4-Layer layout
    - Swap out MCP2515 for MCP2518 (double the SPI bus speed + FIFO + Timestamping)
    - Split SPI bus (remove interrupt lines to make room, change to polling approach)
    - Swap Linear Regs out for Switching Regs
    - Add Test Points
    - Add LED indicators to TTL level RXCAN/TXCAN lines as activity indicators
    - Add Error LEDs to unused interrupt outputs of CAN transceivers
    - Remove CAN channel LEDs from GPIO expander to make room for transceiver enable lines enabling reset from controller
    - Change RTC backup cap footprint
    - Add headers next to buttons
    - Shrink CAN headers from 1x08 to 1x06
    TODO:
    - Minor tweaks, trace nudges
    - Add silkscreen
    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
    [Gateway_Test_Integrated_multiwrite_lint.ino]
2026-02-26 CAN Gateway V02 ready for review
    - Change Project Name
    - Add Silkscreen
    - Add Outline and Standoffs
    - Add GPIO Test Points
2026-03-02 Quick Fix to v02
    - Route CS traces for CAN (Thanks Jeff!)
    - Remove VUSB regulator. USB no longer powers device.
